Aleksandr-Moskvichekov/The-Airship-Project/Проект Дирижабль/Фото/Снимок экрана 2022-01-30 145147.jpg

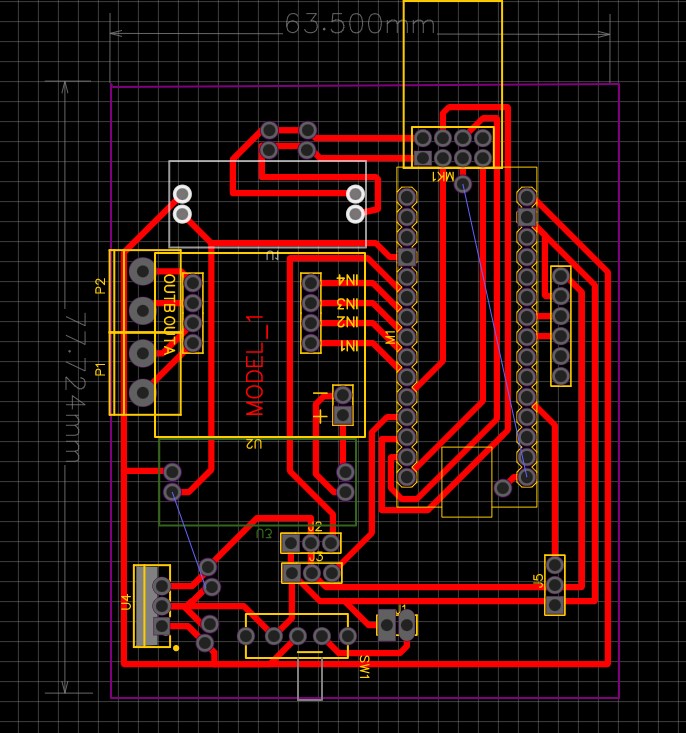
Проект Дирижабль/Фото/Снимок экрана 2022-01-30 145147.jpg
