Aleksandr-Moskvichekov/The-Airship-Project/Проект Дирижабль/Фото/hAwRbF5KHOE.jpg

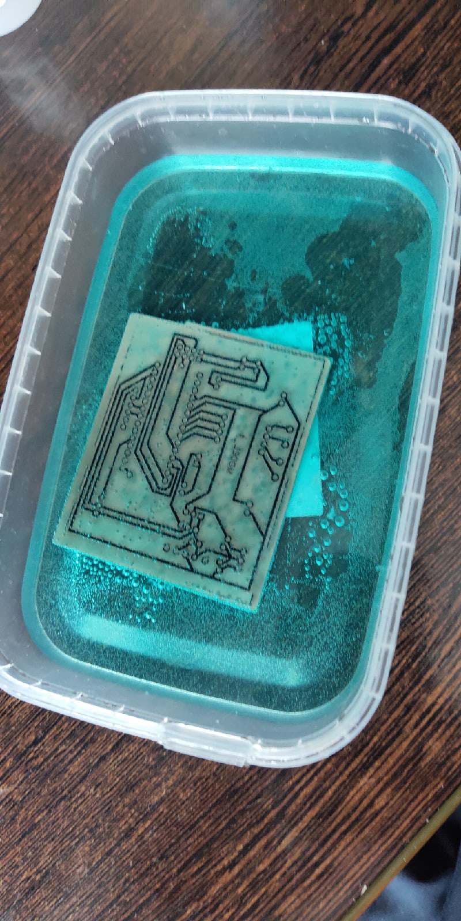
Проект Дирижабль/Фото/hAwRbF5KHOE.jpg
