Aleksandr-Moskvichekov/The-Airship-Project/Проект Дирижабль/Фото/photo_2022-03-21_10-44-58.jpg

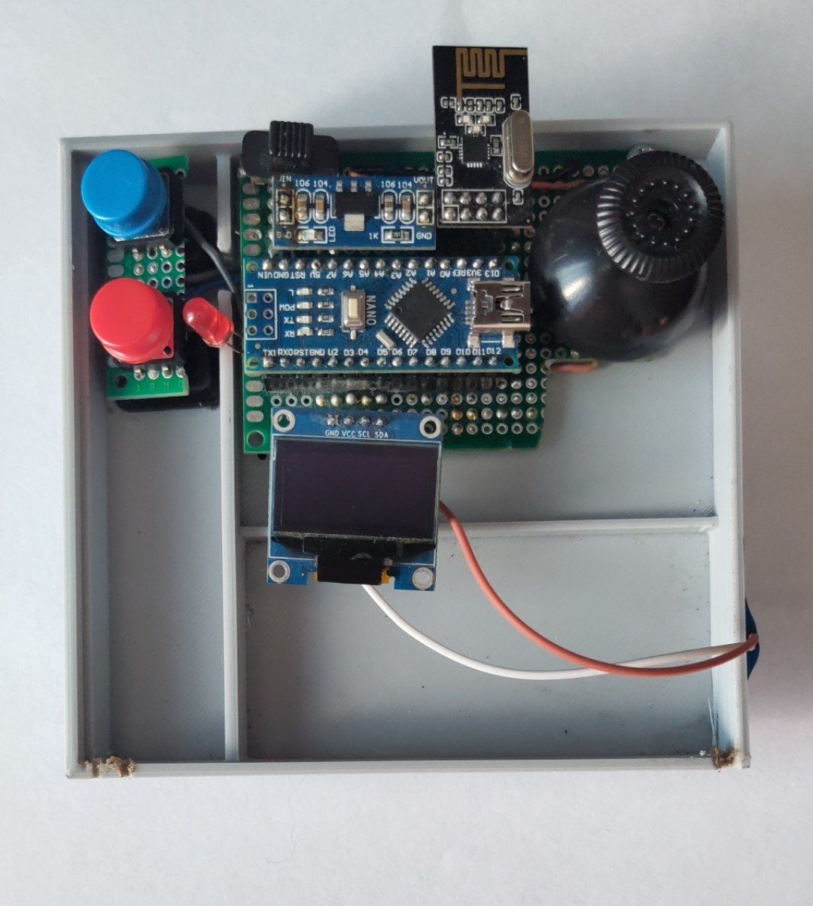
Проект Дирижабль/Фото/photo_2022-03-21_10-44-58.jpg
