Aleksandr-Moskvichekov/The-Airship-Project/Проект Дирижабль/Фото/Снимок экрана 2022-01-24 220842.jpg

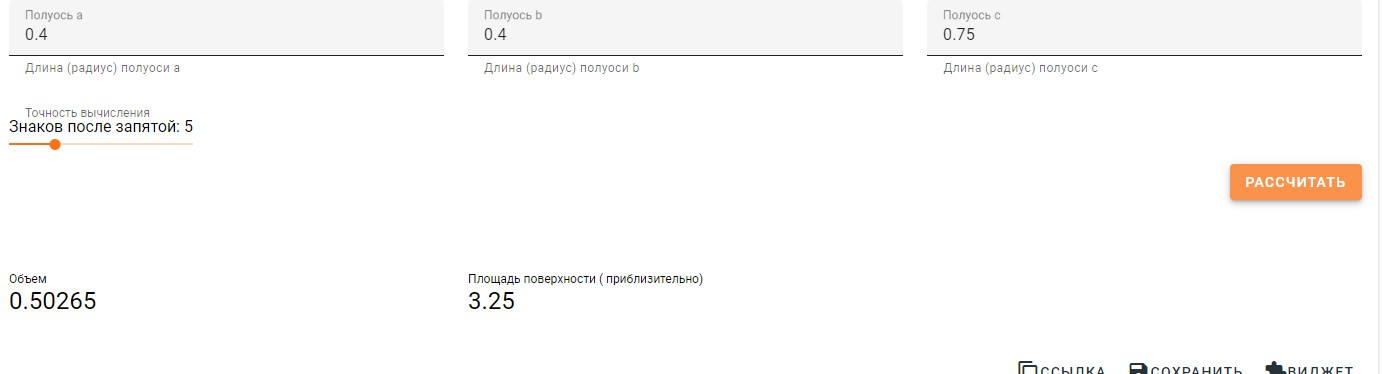
Проект Дирижабль/Фото/Снимок экрана 2022-01-24 220842.jpg
