Aleksandr-Moskvichekov/The-Airship-Project/Проект Дирижабль/3D/Battery_holder_x6.stl

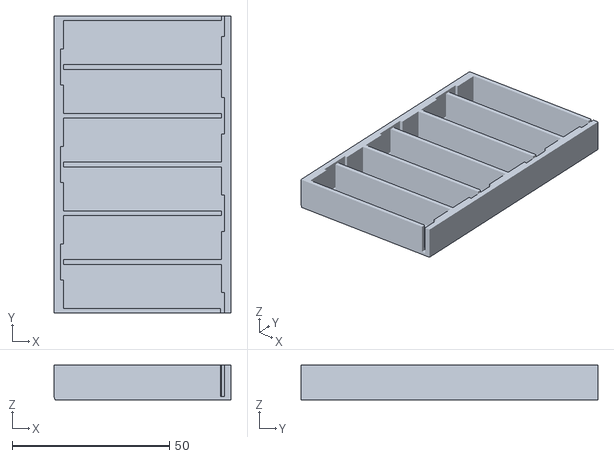
[picture p16: CAD file, 2022-02-23]
Проект Дирижабль/3D/Battery_holder_x6.stl
56.3 x 94.5 x 11.0
