Aleksandr-Moskvichekov/The-Airship-Project/Проект Дирижабль/3D/коробочка под пульт.stl

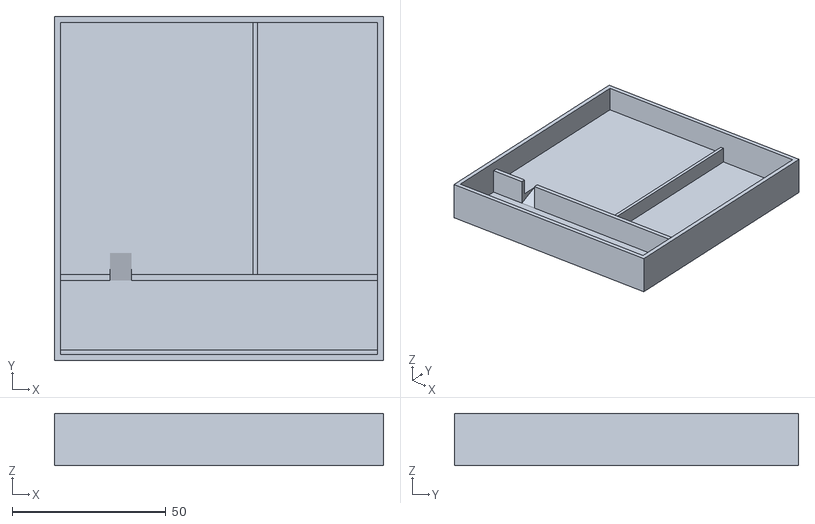
[picture p17: CAD file, 2022-02-14]
Проект Дирижабль/3D/коробочка под пульт.stl
107.0 x 112.0 x 17.0
