Aleksandr-Moskvichekov/The-Airship-Project/(list of files, cad)

Other CAD files:
Проект Дирижабль/3D/Battery_holder_x6.skp
Проект Дирижабль/3D/коробочка под пульт.skp
