Aleksandr-Moskvichekov/The-Airship-Project/Проект Дирижабль/Фото/PCB_PCB_DIrg_4_2022-01-30.pdf

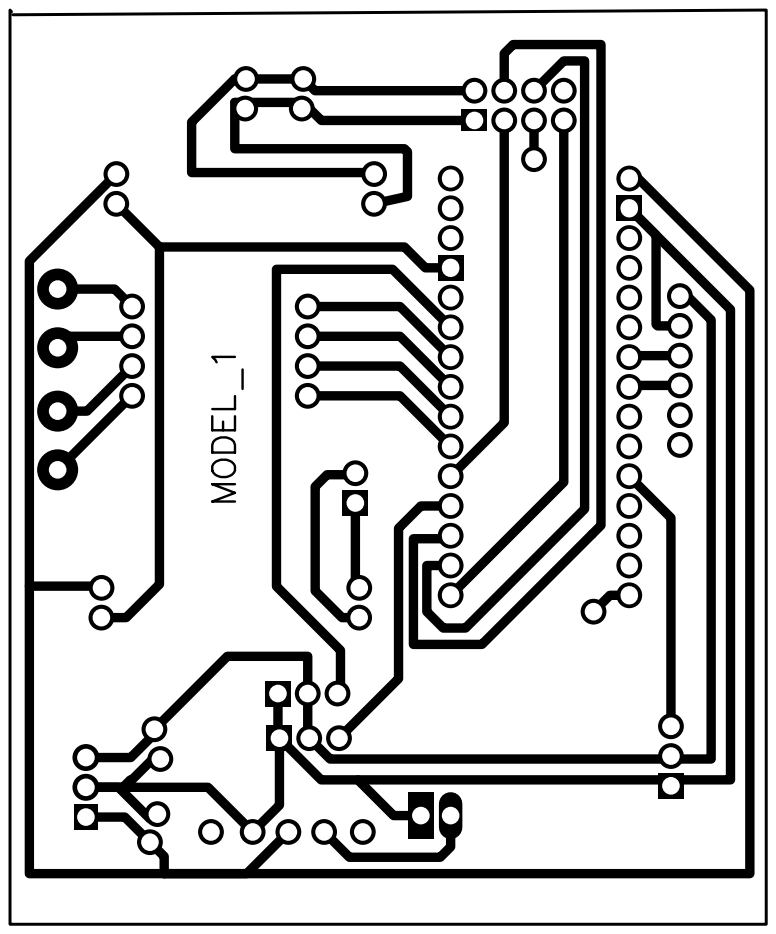
[picture p18: page 1]
