Aleksandr-Moskvichekov/The-Airship-Project/(commit log)

2022-01-18 Create Скетчи
2022-01-18 Add files via upload
    Участки кода взяты с канала AlexGyver
2022-01-18 Update and rename DIRIG/Дистанционное управление с обратной связью/RX_DIR/RX_DIR.ino to ДИРИГ/Дистанционное управление с обратной связью/RX_DIR/RX_DIR.ino
2022-01-21 Create фото
2022-01-31 Новые изменения
2022-02-07 Update Проект Дирижабль.docx
2022-02-13 изменение скетчей
2022-02-14 добавлено 3D
    [коробочка под пульт.skp, коробочка под пульт.stl]
2022-02-23 New 3d modeles
    [Battery_holder_x6.skp, Battery_holder_x6.stl]
2022-03-20 Изменения в скетче
2022-03-21 изменения
